PowerFeather/powerups/README.md

## PowerUPS

Solar-capable UPS for Raspberry Pi (and similar boards) with support for 1S LiPo/Li-Ion/LiFePo4.
