PowerFeather/powerups/(commit log)

2024-10-20 Add powerfeather kicad libs
2024-10-20 Do rough schematic
    [powerups.kicad_sch]
2024-10-20 Remove some unneeded components, use 128kb mcu
    [powerups.kicad_sch]
2024-10-20 Update kicad lib
2024-10-20 Use tps61033 as 5v boost converter
    [powerups.kicad_sch]
2024-10-20 Use FAN48623 boost regulator instead
    [powerups.kicad_sch]
2024-10-20 Use bss138 nmos from mcc instead
    [powerups.kicad_sch]
2024-10-20 Cleanup some schematic parts
    [powerups.kicad_sch]
2024-10-20 Resolve some component parts
    [powerups.kicad_sch]
2024-10-20 Add debug pins
    [powerups.kicad_sch]
2024-10-20 Run annotation
    [powerups.kicad_sch]
2024-10-20 Fix ERC warnings and errors
    [powerups.kicad_sch]
2024-10-20 Fix footprint imports
    [powerups.kicad_pcb, powerups.kicad_sch]
2024-10-20 Rough component placements
    [powerups.kicad_pcb, powerups.kicad_sch]
2024-10-20 Initial connectors
    [powerups.kicad_pcb, powerups.kicad_sch]
2024-10-20 Adjust connectors
    [powerups.kicad_pcb]
2024-10-20 Change diode controller ic
    [powerups.kicad_pcb, powerups.kicad_sch]
2024-10-20 Some schematic fixes
    - visual organization
    - initial pin assignments to microcontroller
    - changes to power section
    [powerups.kicad_pcb, powerups.kicad_sch]
2024-10-20 Use shunt resistors and add i2c pull ups
    [powerups.kicad_pcb, powerups.kicad_sch]
2024-10-20 Fix some erc errors
    [powerups.kicad_sch]
2024-10-20 Align to grid
    [powerups.kicad_sch]
2024-10-20 Fill in missing footprints
    [powerups.kicad_pcb, powerups.kicad_sch]
2024-10-20 Add missing footprints, organize rough layout
    [powerups.kicad_pcb, powerups.kicad_sch]
2024-10-20 Fix erc error on two connected load switch
    [powerups.kicad_pcb, powerups.kicad_sch]
2024-10-20 Add connections for other boards
    [powerups.kicad_pcb, powerups.kicad_sch]
2024-10-20 Reannotate schematic
    [powerups.kicad_pcb, powerups.kicad_sch]
2024-10-20 Refine rough component placements
    [powerups.kicad_pcb, powerups.kicad_sch]
2024-10-20 Fix max17260 circuit
    [powerups.kicad_pcb, powerups.kicad_sch]
2024-10-20 Cleanup symbol details
    [powerups.kicad_pcb, powerups.kicad_sch]
2024-10-20 Some more cleanup
    [powerups.kicad_sch]
2024-10-20 More cleanup
    [powerups.kicad_pcb, powerups.kicad_sch]
2024-10-20 Remove unnecessary field
    [powerups.kicad_pcb]
2024-10-20 Some cleanup
    [powerups.kicad_pcb, powerups.kicad_sch]
2024-10-20 Change crystal to one available from Mouser
    [powerups.kicad_pcb, powerups.kicad_sch]
2024-10-20 Change crystal caps
    [powerups.kicad_sch]
2024-10-20 Some more refinements
    [powerups.kicad_pcb, powerups.kicad_sch]
2024-10-20 More cleanups
    [powerups.kicad_pcb, powerups.kicad_sch]
2024-10-20 Change value for QON button
    [powerups.kicad_sch]
2024-10-20 Change micro bulk cap
    [powerups.kicad_sch]
2024-10-20 Fix pcb import warnings
    [powerups.kicad_pcb, powerups.kicad_sch]
2024-10-20 Add net classes
    [powerups.kicad_pcb, powerups.kicad_sch]
2024-10-20 Replace ap22916
    [powerups.kicad_pcb, powerups.kicad_sch]
2024-10-20 Initial layout of power traces
    [powerups.kicad_pcb]
2024-10-20 Route signals
    [powerups.kicad_pcb, powerups.kicad_sch]
2024-10-20 Route all connections
    [powerups.kicad_pcb]
2024-10-20 Disable 5V boost reg by default
    [powerups.kicad_pcb, powerups.kicad_sch]
2024-10-20 Fix some warnings and errors
    [powerups.kicad_pcb, powerups.kicad_sch]
2024-10-20 Fix more drc errors
    [powerups.kicad_pcb]
2024-10-20 Remove unconnected segments
    [powerups.kicad_pcb]
2024-10-20 Fix all warnings
    [powerups.kicad_pcb]
2024-10-20 Some fixes to power schem
    [powerups.kicad_pcb, powerups.kicad_sch]
2024-10-20 Use 5V boost output as vcc
    [powerups.kicad_sch]
2024-10-20 More fixes to schematic
    [powerups.kicad_pcb, powerups.kicad_sch]
2024-10-20 Add support for bypass pin
    [powerups.kicad_pcb, powerups.kicad_sch]
2024-10-20 Some changes
    [powerups.kicad_pcb, powerups.kicad_sch]
2024-10-20 Initial pcb relayout
    [powerups.kicad_pcb, powerups.kicad_sch]
2024-10-20 Route most of all signals again
    [powerups.kicad_pcb]
2024-10-20 Solve all unconnected items
    [powerups.kicad_pcb]
2024-10-20 Remove warnings
    [powerups.kicad_pcb]
2024-10-20 External tap changes
    - use smaller footprint for button
    - add tap for thermistor
    [powerups.kicad_pcb, powerups.kicad_sch]
2024-10-20 Add missing 3d models
    [powerups.kicad_pcb]
2024-10-20 Add additional ground vias
    [powerups.kicad_pcb]
2024-10-20 Add pogo pin models
    [powerups.kicad_pcb, powerups.kicad_sch]
2024-10-25 Replace power or with diode mux
    [powerups.kicad_pcb, powerups.kicad_sch]
2024-10-25 More changes to charger input
    [powerups.kicad_pcb, powerups.kicad_sch]
2024-10-25 Fix some tps2120 connections
    [powerups.kicad_pcb, powerups.kicad_sch]
2024-10-25 Make routing changes
    [powerups.kicad_pcb, powerups.kicad_sch]
2024-10-25 Fix drc errors after retrace
    [powerups.kicad_pcb]
2024-10-25 Add more gnd vias
    [powerups.kicad_pcb]
2024-10-25 Fix vsys copper pour
    [powerups.kicad_pcb]
2024-10-25 Decrease gaps between copper pours
    [powerups.kicad_pcb]
2024-10-25 Add missing mouser part numbers
    [powerups.kicad_sch]
2024-10-25 Fix some issues with microcontroller circuit
    - Use same UPDI relative pin order
    - Fix wrong crystal cap value
    [powerups.kicad_pcb, powerups.kicad_sch]
2024-10-25 More general cleanup
    [powerups.kicad_sch]
2024-10-26 Fixes to ideal diode circuit
    - Use ideal diode + high side switch of nv68621
    - Fix footprint of dmn3016
    [powerups.kicad_pcb, powerups.kicad_sch]
2024-10-26 Connect fan48623 nc pins to ground, add more ground vias
    [powerups.kicad_pcb, powerups.kicad_sch]
2024-10-26 Minor changes to max17260 layout
    [powerups.kicad_pcb]
2024-10-26 Small adjustments to mux and charger circuit
    [powerups.kicad_pcb, powerups.kicad_sch]
2024-10-26 Change revision to 0.9.1
    [powerups.kicad_sch]
2024-10-26 Add datasheet to sense resistors as well
    [powerups.kicad_pcb, powerups.kicad_sch]
2024-10-26 Fixes to bom
    [powerups.kicad_pcb, powerups.kicad_sch]
2024-10-26 Generate fab outputs
    [bom.csv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]
2024-10-31 Replace vddio2 cap with bigger one
    [powerups.kicad_pcb, powerups.kicad_sch]
2024-11-01 Change tps2120 ss value
    [powerups.kicad_pcb, powerups.kicad_sch]
2024-11-01 Fix terminal block part number
    [powerups.kicad_pcb, powerups.kicad_sch]
2024-11-01 Fix fan48623 footprint
    [powerups.kicad_pcb, powerups.kicad_sch]
2024-11-01 Fix missing solder mask openings
    [powerups.kicad_pcb]
2024-11-01 Fix solder masks
    [powerups.kicad_pcb]
2024-11-01 Update sheets version
    Add version silkscreen
    [powerups.kicad_pcb, powerups.kicad_sch]
2024-11-01 Fix manufacturer comment on BOM
    [powerups.kicad_pcb, powerups.kicad_sch]
2024-11-01 Generate output files
    [bom.csv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]
2024-11-01 Fix set 3d model for fan48623
    [powerups.kicad_pcb]
2024-11-01 Refresh output files
    [powerups-B_Cu.gbl, powerups-B_Mask.gbs, powerups-B_Paste.gbp, powerups-B_Silkscreen.gbo, powerups-Edge_Cuts.gm1, powerups-F_Cu.gtl, powerups-F_Mask.gts, powerups-F_Paste.gtp]
2024-11-10 Fix NCV68261 footprint and symbol
    [powerups.kicad_pcb, powerups.kicad_sch]
2024-11-10 Leave ncv68261 thermal pad floating
    [powerups.kicad_pcb, powerups.kicad_sch]
2024-11-10 Update version
    [powerups.kicad_pcb, powerups.kicad_sch]
2024-11-10 Update fab outputs
    [bom.csv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]
